Fishyfabspnw/PTC-Heater-Duct/README.md

# PTC Heater Mount and Duct




## Installation Instructions

### ⚠️ Safety Notice
This mount is intended for use with PTC heaters inside enclosed 3D printers.
Ensure all wiring is properly insulated and strain-relieved. (Ensure a thermal cutoff fuse is implemented directly touching the heater)
Never power the heater without proper thermal control and safety protection.

---

### Required Hardware

-BOM (https://github.com/Fishyfabspnw/ptc-heater-mount-and-duct/blob/main/BOM.md#bill-of-materials)
- High-temp wire (silicone insulated recommended/ or FEP wire)
- Thermal fuse (REQUIRED!!!)
- SSR( Solid State Relay)
- Cartridge Style Thermistor

---

### Print Recommendations For Wire Shroud (High Temp FILAMENTS ONLY!!!)

Material: ASA-GF / PPS-CF / NYLON 
Do NOT use PLA inside heated chambers.  
Walls: 4+  
Infill: 45%+  
First Layer Height: 0.25mm
Layer Height: 0.2mm    
Seam: Back

---

### Assembly Steps

1. Prep SLM/Laser Cut part by tapping.  
2. Implement a 121c thermal cutoff fuse to the power loop. Safely drill a hole through the fins in the PTC-Heater to allow for a thermistor to be placed into the fins, apply boron nitrade paste into the hole and then insert the thermistor. (i drilled and used a rivet, and ring terminal around the rivot then attatched the 121c thermal cutoff fuse to that and bent it so it was making contact with the heater, apply Red RTV sealant here if needed.).


5. Mount standoff's on the orginal PTC Heater shroud with the M4x8mm SHCS.

6. Mount the SLM printed duct to the other side of the standoff with the M4x8mm SHCS.

7. Mount fan and laser cut Part. (The laser cut part is meant to be sandwiched between the fan and the SLM printed duct)

8. Mount wire shroud over the front with the M3x45mm SHCS.

9. Mount the assembly to the extrusion with the M5x8mm SHCS.

---

### Recommended Operating Limits

- Max chamber temperature: [85c]
- Heater wattage tested: [250W]
- Max Heater Temp [110c]

---

### Notes

- Designed for enclosed CoreXY-style printers.
- Ensure adequate airflow across heater fins.
- Add a thermal fuse in series for additional safety.

## Contents

* `Cad` – STEP CAD exports.
*  `SLM` – SLM Parts.
*  `STL` – 3d Printed Part.
*  `Laser Cut Part` – Sheet Metal Parts.
* `BOM.md` – bill of materials with suppliers/part numbers.

## Heater

This mount and duct is designed for the [PTC Heater](https://www.amazon.com/dp/B07NYX5DKD).

## License

This project is licensed under the [Creative Commons Attribution 4.0 International](https://creativecommons.org/licenses/by/4.0/) (CC BY 4.0) license. See the `LICENSE` file for details.
