Fishyfabspnw/PTC-Heater-Duct/CAD/PTC HEATER.step

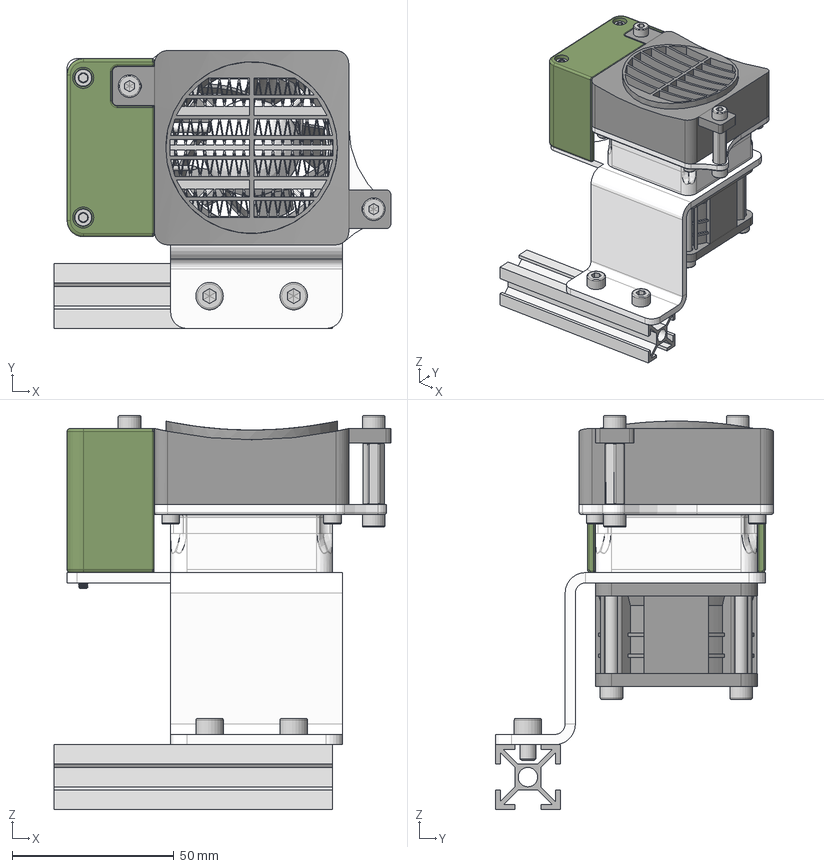
[picture p1: CAD file, 2026-05-26]
CAD/PTC HEATER.step
104.0 x 85.8 x 121.7 mm
Корпус PTC
PTC нагреватель
Проставка
BRACKET_LASER_CUT
d01_5_02_10_0200_0
DIN 912 - M5 x 0.8 x 8 Steel 4.6 Plain x 2
DIN 912 - M4 x 0.7 x 40 Steel 4.6 Plain x 4
DIN 912 - M3 x 0.5 x 8 Steel 4.6 Plain x 4
DIN 912 - M4 x 0.7 x 8 Steel 4.6 Plain x 4
91290A079_Black-Oxide Alloy Steel Socket Head Screw x 2
94868A043_Female Threaded Hex Standoff x 2
Thermistor
Axial Thermal Fuse Horizontal
97447A015_Aluminum Blind Rivets with Aluminum Mandrel
