Fishyfabspnw/PTC-Heater-Duct/Laser Cut Part/LASER CUT PART.step

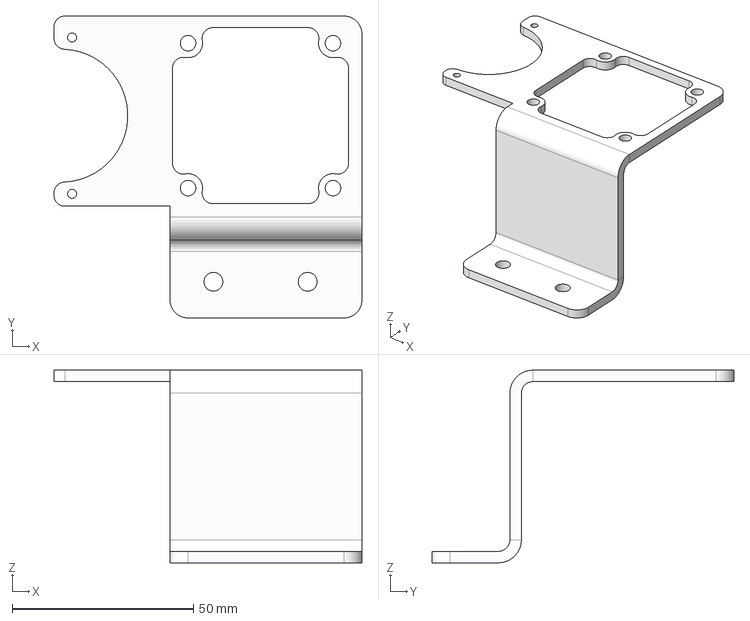
[picture p2: CAD file, 2026-05-26]
Laser Cut Part/LASER CUT PART.step
85.0 x 83.3 x 53.2 mm
