Fishyfabspnw/PTC-Heater-Duct/SLM/SLM PRINTED DUCT.stl

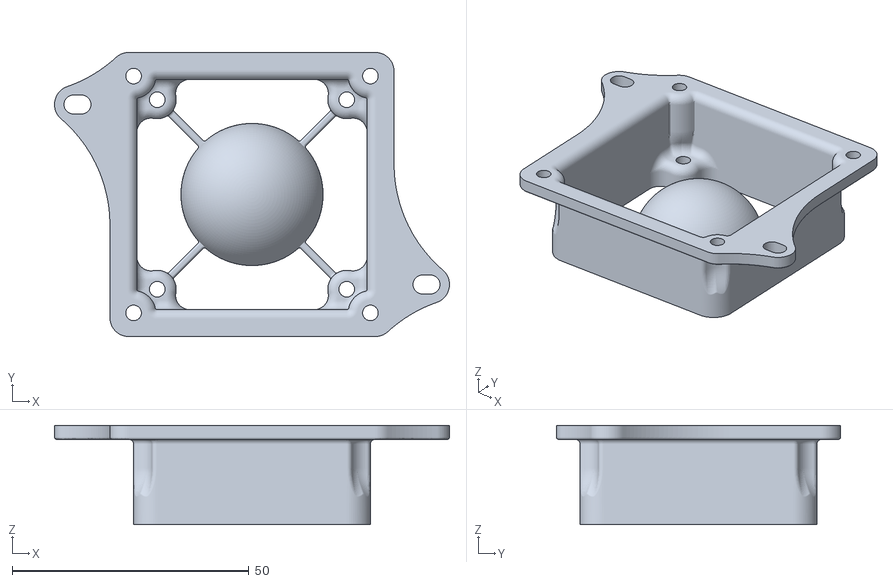
[picture p3: CAD file, 2026-05-26]
SLM/SLM PRINTED DUCT.stl
83.4 x 60.0 x 21.0
