Fishyfabspnw/PTC-Heater-Duct/STL/Wire Shroud ( High Temp Filament only).stl

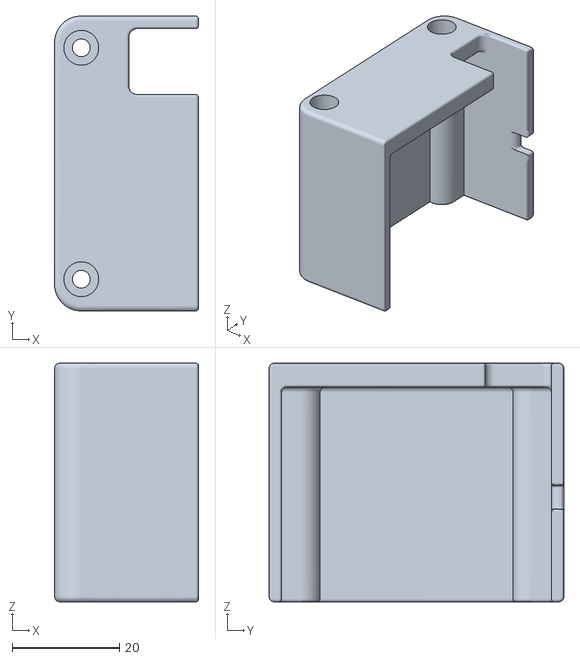
[picture p4: CAD file, 2026-03-01]
STL/Wire Shroud ( High Temp Filament only).stl
26.9 x 55.0 x 44.5
