Fishyfabspnw/PTC-Heater-Duct/(commit log)

2026-03-01 Create Wire Shroud
2026-05-26 Delete CAD/PTC HEATER MOUNT.STEP
    Delete Old Version
    [PTC HEATER MOUNT.STEP]
2026-05-26 Rename PTC HEATER.step to PTC HEATER MOUNT.step
    [PTC HEATER MOUNT.step, PTC HEATER.step]
2026-05-26 New Laser Cut Part
    [LASER CUT PART.step]
2026-05-26 New Updated SLM Duct
    Tapped hole sizing fixed.
    Pass through hole sizing fixed.
    [SLM PRINTED DUCT.stl]
2026-05-26 Delete SLM/SLM_PRINTED_DUCT.stl
    Delete old duct
    [SLM_PRINTED_DUCT.stl]
2026-05-26 Add files via upload
    3.3mm tap hole fixed
    [SLM PRINTED DUCT.stl]
